strility/-/机器人学院项目报告-徐炜涛-罗文荣.docx

机器人学院项目报告

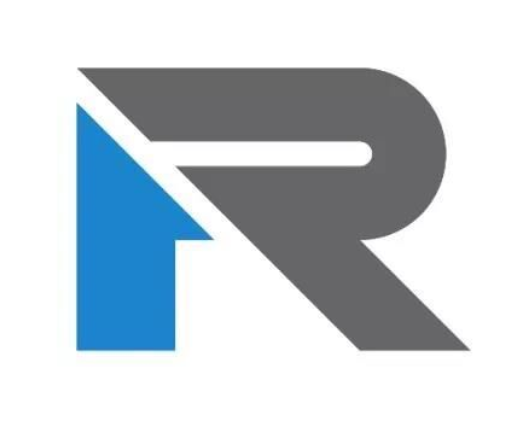
[picture p1: figure]

项 目 题 目： MADE小船

学 院 名 称： 机器人学院

专 业： 网络工程

班 级： 网络182

姓 名： 徐炜涛 学 号 18401190125

姓 名： 罗文荣 学 号 18404130277

指 导 教 师： 汪保

完成日期： 2019 年 11 月 10 日

目录

摘要¨¨¨¨¨¨¨¨¨¨¨¨¨¨¨¨¨¨¨¨¨¨¨¨¨¨¨¨¨¨¨¨¨¨¨¨¨¨¨¨¨¨¨¨¨¨¨¨¨¨¨¨¨¨¨¨¨¨¨¨¨¨¨¨¨¨3

前言¨¨¨¨¨¨¨¨¨¨¨¨¨¨¨¨¨¨¨¨¨¨¨¨¨¨¨¨¨¨¨¨¨¨¨¨¨¨¨¨¨¨¨¨¨¨¨¨¨¨¨¨¨¨¨¨¨¨¨¨¨¨¨¨¨¨4

一、项目背景¨¨¨¨¨¨¨¨¨¨¨¨¨¨¨¨¨¨¨¨¨¨¨¨¨¨¨¨¨¨¨¨¨¨¨¨¨¨¨¨¨¨¨¨¨¨¨¨¨¨¨¨¨¨¨¨5

1.1设计理由（设计背景）¨¨¨¨¨¨¨¨¨¨¨¨¨¨¨¨¨¨¨¨¨¨¨¨¨¨¨¨¨¨¨¨¨¨¨¨¨¨¨¨¨¨5

1.2项目要求介绍¨¨¨¨¨¨¨¨¨¨¨¨¨¨¨¨¨¨¨¨¨¨¨¨¨¨¨¨¨¨¨¨¨¨¨¨¨¨¨¨¨¨¨¨¨¨¨¨¨¨¨¨5

二、小船材料与制造操作过程¨¨¨¨¨¨¨¨¨¨¨¨¨¨¨¨¨¨¨¨¨¨¨¨¨¨¨¨¨¨¨¨¨¨¨¨¨¨¨5

2.1小船材料简介¨¨¨¨¨¨¨¨¨¨¨¨¨¨¨¨¨¨¨¨¨¨¨¨¨¨¨¨¨¨¨¨¨¨¨¨¨¨¨¨¨¨¨¨¨¨¨¨¨¨¨¨5

2.2小船工艺与设计¨¨¨¨¨¨¨¨¨¨¨¨¨¨¨¨¨¨¨¨¨¨¨¨¨¨¨¨¨¨¨¨¨¨¨¨¨¨¨¨¨¨¨¨¨¨¨¨¨¨5

三、小船的推导思路与代码¨¨¨¨¨¨¨¨¨¨¨¨¨¨¨¨¨¨¨¨¨¨¨¨¨¨¨¨¨¨¨¨¨¨¨¨¨¨¨¨¨¨6

3.1推导模型¨¨¨¨¨¨¨¨¨¨¨¨¨¨¨¨¨¨¨¨¨¨¨¨¨¨¨¨¨¨¨¨¨¨¨¨¨¨¨¨¨¨¨¨¨¨¨¨¨¨¨¨¨¨¨¨¨7

3.1.1整体思路¨¨¨¨¨¨¨¨¨¨¨¨¨¨¨¨¨¨¨¨¨¨¨¨¨¨¨¨¨¨¨¨¨¨¨¨¨¨¨¨¨¨¨¨¨¨¨¨¨¨¨¨7

3.1.2重心、浮心¨¨¨¨¨¨¨¨¨¨¨¨¨¨¨¨¨¨¨¨¨¨¨¨¨¨¨¨¨¨¨¨¨¨¨¨¨¨¨¨¨¨¨¨¨¨¨¨¨¨8

3.1.3四个阶段¨¨¨¨¨¨¨¨¨¨¨¨¨¨¨¨¨¨¨¨¨¨¨¨¨¨¨¨¨¨¨¨¨¨¨¨¨¨¨¨¨¨¨¨¨¨¨¨¨¨¨¨8

3.1.3.1第一阶段0-1¨¨¨¨¨¨¨¨¨¨¨¨¨¨¨¨¨¨¨¨¨¨¨¨¨¨¨¨¨¨¨¨¨¨¨¨¨¨¨¨¨¨¨8

3.1.3.2第二阶段1-90¨¨¨¨¨¨¨¨¨¨¨¨¨¨¨¨¨¨¨¨¨¨¨¨¨¨¨¨¨¨¨¨¨¨¨¨¨¨¨¨¨10

3.1.3.3第三阶段90-2¨¨¨¨¨¨¨¨¨¨¨¨¨¨¨¨¨¨¨¨¨¨¨¨¨¨¨¨¨¨¨¨¨¨¨¨¨¨¨¨11

3.1.3.3第四阶段2-180¨¨¨¨¨¨¨¨¨¨¨¨¨¨¨¨¨¨¨¨¨¨¨¨¨¨¨¨¨¨¨¨¨¨¨¨¨¨¨12

3.2代码设计¨¨¨¨¨¨¨¨¨¨¨¨¨¨¨¨¨¨¨¨¨¨¨¨¨¨¨¨¨¨¨¨¨¨¨¨¨¨¨¨¨¨¨¨¨¨¨¨¨¨¨¨¨¨¨¨13

4.1题目模型解答¨¨¨¨¨¨¨¨¨¨¨¨¨¨¨¨¨¨¨¨¨¨¨¨¨¨¨¨¨¨¨¨¨¨¨¨¨¨¨¨¨¨¨¨¨¨¨¨¨¨14

四、结论与感悟¨¨¨¨¨¨¨¨¨¨¨¨¨¨¨¨¨¨¨¨¨¨¨¨¨¨¨¨¨¨¨¨¨¨¨¨¨¨¨¨¨¨¨¨¨¨¨¨¨¨¨¨¨18

参考文献¨¨¨¨¨¨¨¨¨¨¨¨¨¨¨¨¨¨¨¨¨¨¨¨¨¨¨¨¨¨¨¨¨¨¨¨¨¨¨¨¨¨¨¨¨¨¨¨¨¨¨¨¨¨¨¨¨¨¨¨19

MADE小船设计与实现

# 摘要：船舶在海上行驶会遇到海浪导致船舶飘忽不定，因此在设计船舶的时会将船设计地有较好地稳定性，船舶的稳定性是指船舶在有限的作用下不会倾覆，倾侧性消失后能恢复到正常状态的能力。

# 决定船舶稳定性的一大关键元素就是复原力矩， 复原力矩是指船舶受外力作用倾斜时由于重力和浮力的作用点不在同一铅垂线上所产生的使船恢复正态的恢复力矩当重心和浮心不在同一垂线上，重力和浮力形成力偶，促使船回到初始平衡位置，此时的复原力矩为正值。当重力和浮力形成的力偶，促使船继续横倾，此时的复原力矩为负值，当复原力矩达到负值的一瞬间就是最大AVS消失角。

# 对于船舶稳定性我们可以通过设计船的模型(船体方程)和改变船的重心来达到我们需要的最大恢复力矩，使船达到我们的要求。

# 模型设计与代码设计：本文采用了先推导公再结合代码迭代设计船体最后进行制作。

# 文中主要就对小船的相关结构设计与恢复力矩计算做了相关的综述。

关键词：微积分；船舶稳定性；恢复力矩；AVS稳定消失角

前言

为了让我们数学更贴近生活也为了增强我们对微积分认识，学院布置了小船项目，小船项目是通过教师给出一定要求，里面包含物理、数学、编程等一些列的要求，整合多种工具最后完成小船，小船项目要求分为几种测试，静平衡测试：船满载时放入水中，能够漂浮，且甲板平面与标识线（水面）平行。稳定性测试： 主要观测稳性消失角是否达到 135±10°。最大恢复力矩测试：根据 135°倾角时围绕浮心的转动惯量 J（单位用 kg·m2)和测量所得周期 T(单位用 s),计算得到该船的最大恢复力矩值，大于或等于 0.2 N·m 的该项合格，小于 0.2 N·m 的不合格。行进性能测试：单位时间内速度最大。

一、项目背景

1.1设计背景

为了加强我们对物理、微积分和编程与现实的联系，学院开展了小船项目：目的是培养综合运用所学的基础理论，基本知识和技能，提高分析解决实际问题的能力。提高实际工作能力和协作能力：如调查研究、查阅文献和收集资料并进行分析的能力；制定设计或实验方案的能力；设计、计算和绘图能力；总结提高撰写论文的能力。

1.2项目要求介绍

小船项目要求做出的小船满足以下要求：船满载时放入水中，能够漂浮，且甲板平面与标识线（水面）平行。主要观测稳性消失角是达到 135±10°。最大恢复力矩测试：在 135°倾角时围绕浮心的恢复力矩大于等于 0.2 N·m 的该项合格。行进性能测试：给予相同的力在一定距离内行驶时间越短得分越高。

二、小船材料与制造操作过程

2.１小船材料简介

学院提供硬质板、铁质重物、铝质桅杆、塑料薄膜、胶带、胶水、剪刀、美工刀。如图2-1：

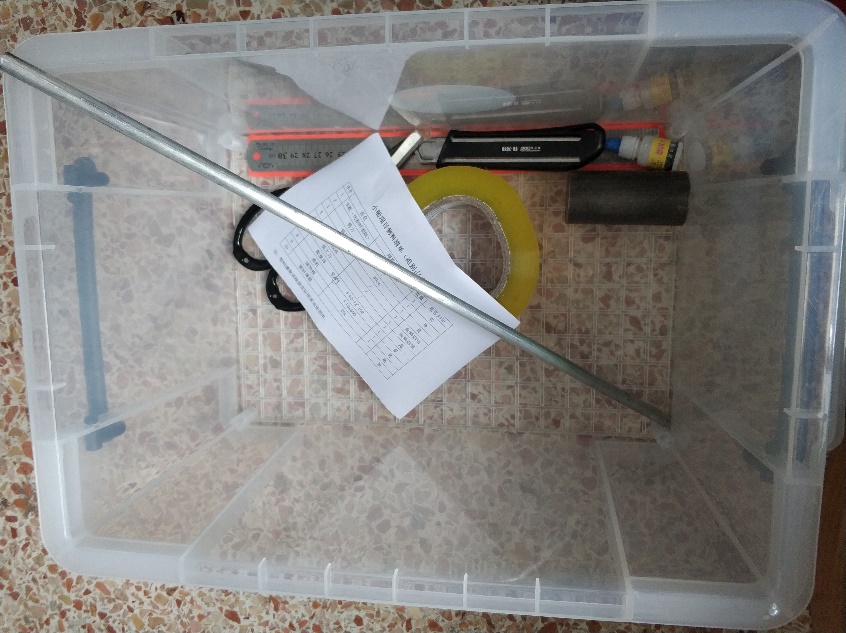
[picture p2: figure]

图 2-1

2.2小船工艺与设计

小船船体设计需要方程，方程设计选择的是二次方程，因为二次方程有着良好的对称性，并且二元二次方程更容易计算，虽然最终计算是交给计算机计算，但是由于二次方程本身简单，我们能人为化简积分，可以较大减少计算机计算时间。然后我们可以对方程进行计算，通过计算以后得出相应数据后就可以设计船体，还可以对船体进行预留装饰位置，然后使用CAD画出平面切割图2-2，也可以使用solidwork建立3D图形模拟，如2-3图：(这里的图形为最终完成的图形设计)

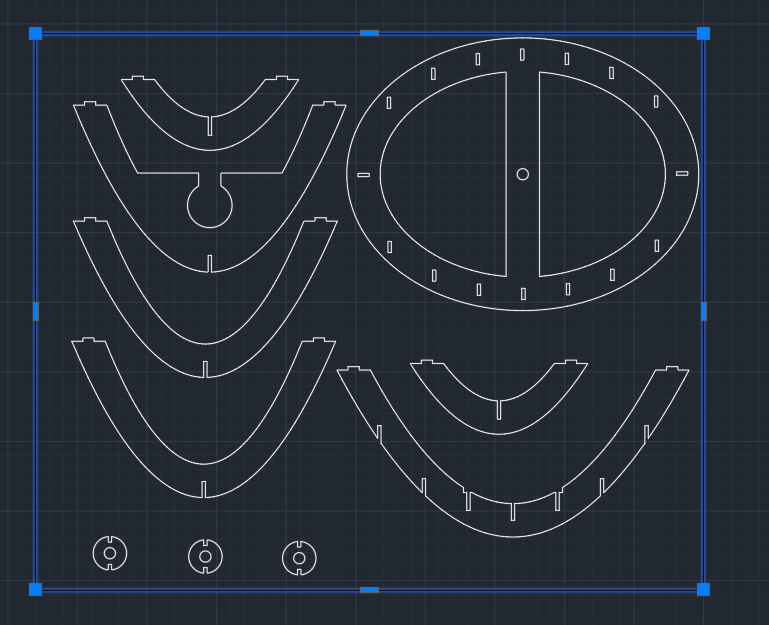
[picture p3: figure]
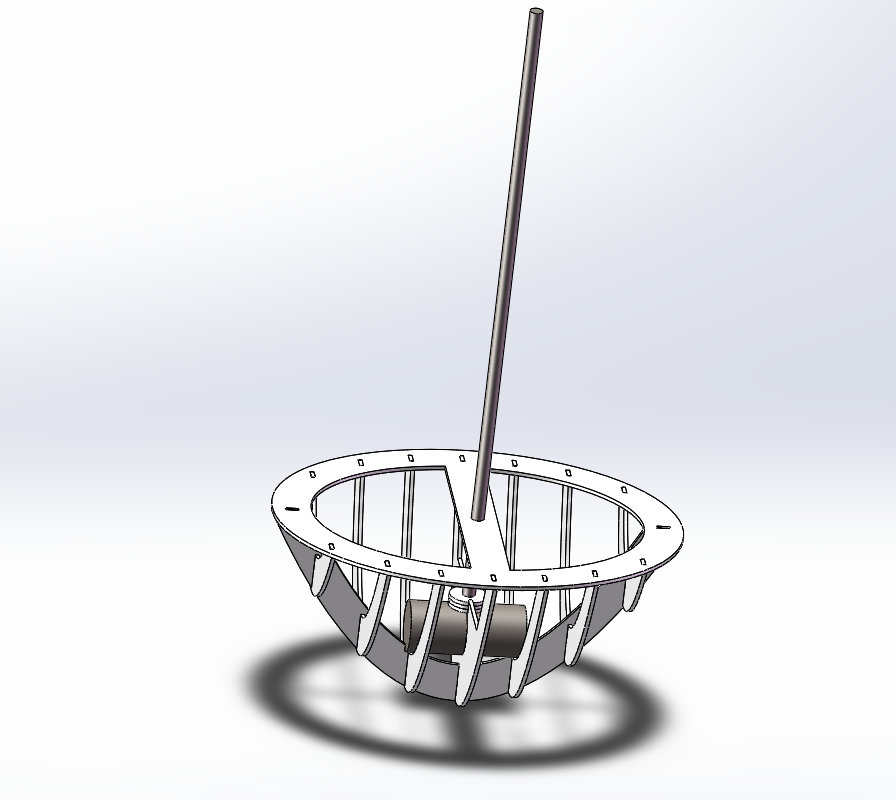
[picture p4: figure]

图2-2 图2-3

然后让老师审核切割图纸，在图纸不存在切割问题后就可以交给老师切割，切割过程不参与。最后组装、做好防水处理与装饰。

三、小船方程推导思路与代码

3.1推导模型

3.1.1整体思路

首先船体是三维立体图形，我们以（0，0，0）为原点这个点也是船的最低点，我们的目标是使得制造出来的船稳定消失角处于135±10°。所以这是最低的限定条件，由于物理知识我们可以知道船只要船在水中浮起，浮力永远等于重力（不进水的情况下）这样我们得到了一个重要的限定方程。①，因此无论后面吃水线如何变化都处于这个限定方程里面。

整体思路的思维导图3-1：

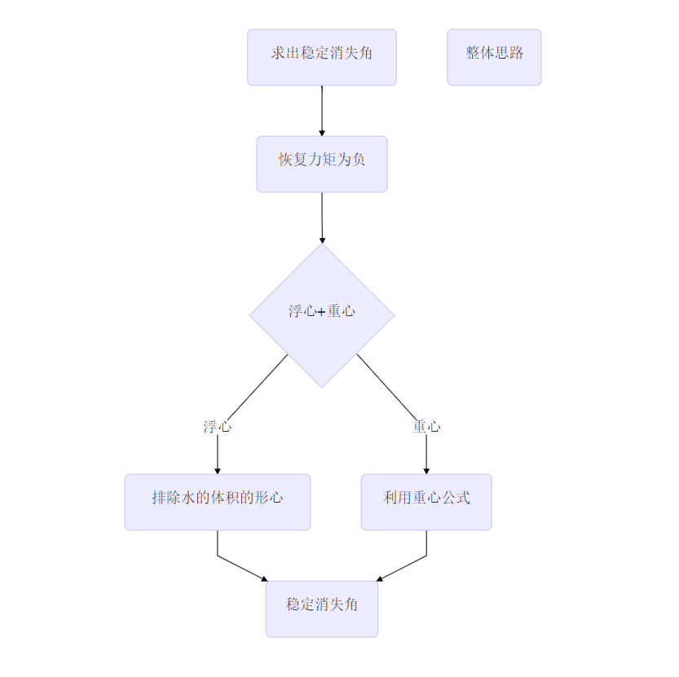
[picture p5: figure]

图 3-1

3.1.2重心、浮心

通过思维导图我们得知为了求出稳定消失角需要求出重心和排水的形心，根据测量我们得知材料的总重，我们可以通过粗略估计所需的船体重量就可以算出总重量，得出总体总量就可以利用①得出排水体积，我们知道我们的方程为我们可以粗略设定A、B和船高H，然后可以利用。

重心方程求解：

②(,,)

就可以得出船体的重心位置。

接下来就是浮心位置：浮心为排开水体积的形心，由于我们选择的是对称性良好的二元二次方程，所以我们在计算吃水线的时候我们可以选择对一个象限进行积分然后推广到其余四个象限。（由于我们是按照Y轴旋转的，所以可以忽略Y轴的积分，所以此处如果选择二重积分也是可以的，但是三重积分更为直观）

浮心求解：

我们需要得到排开水的体积，可以利用我们在前面的到重要限定方程使用①推导出来积分区域为：（，， ）

通过程序二分迭代得到吃水线，得到吃水线以后我们可以使用形心定义求得他在静水中的浮心，分别对x、z轴使用③和④就能得到浮心坐标

3.1.3四个阶段

求得静止时刻的浮心以后我们开始求解从0-180之间的复原力矩，求得复原力矩=复原力臂x力，力为重力，力臂我们可以用浮心和重心求得力臂长度。我们选择以船体为固定中心，让水面旋转，由于绕着Y轴旋转，我们将平立体船和水面看成二维图像，这样更直观，并且这个时候我们的模型可以简化成为一个平面与直线，求解这两个方程的解就能得到他们的交点类似图中的两个交点，我们知道排水体积不变，那么我们设从0°开始往上增加，每增加1°就能得到相对应的截距C这样，就是已知方程了，再联立得到下面图3-1-4

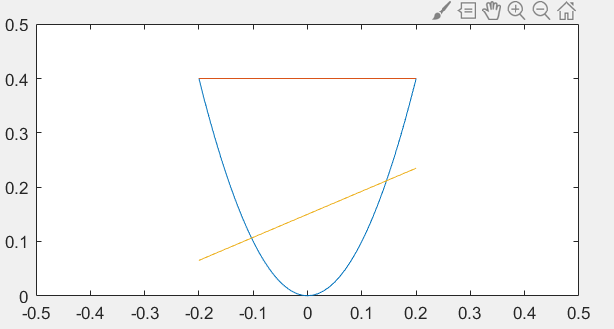
[picture p6: figure]

图3-1-4

而联立方程以后我们可得

方程的解为与，当船体到达吃水线附近的极限值也是约束条件与

这个过程需要分成4个阶段

这4个阶段的思维导图3-1-5：

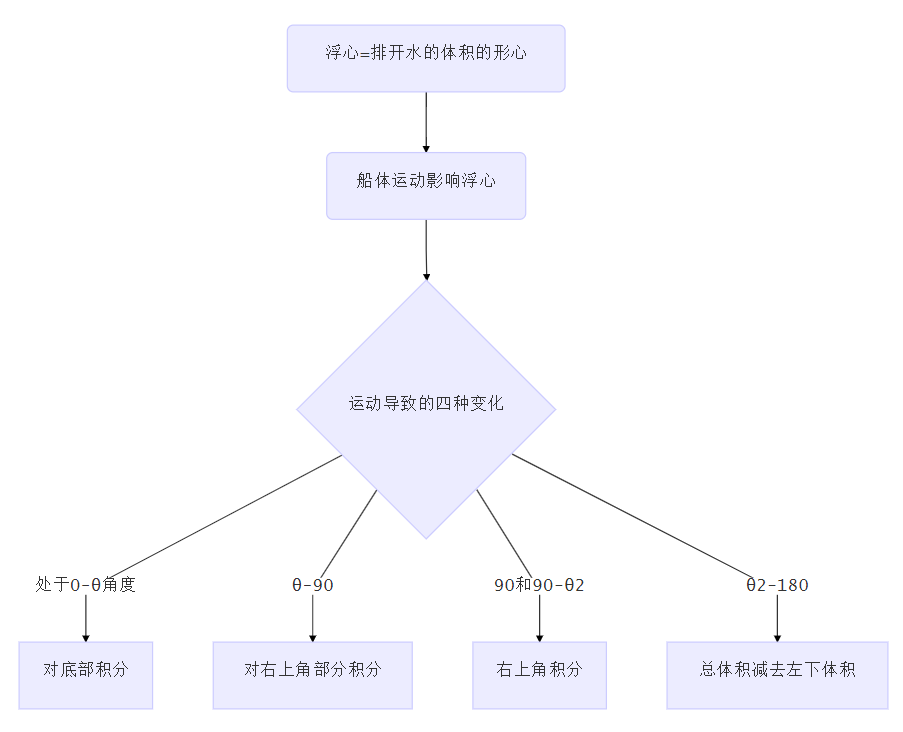
[picture p7: figure]

图 3-1-5

3.1.3.1第一阶段0-1

阶段二维图3-1-3-1-1与三维图3-1-3-2-2

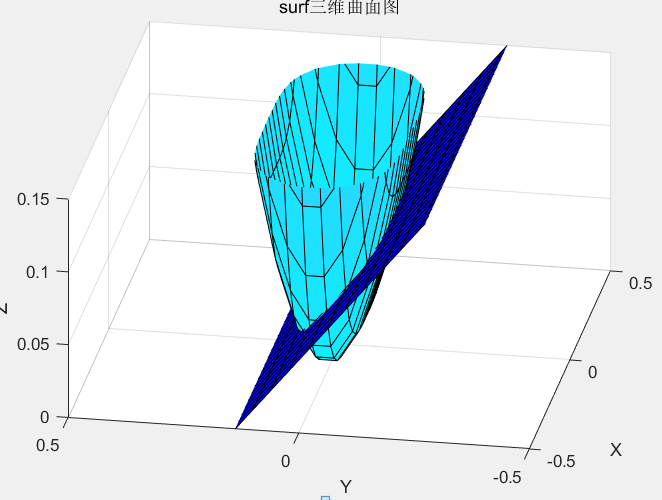
[picture p8: figure]

图3-1-3-1-1 图3-1-3-1-2

当角度小于的时候的积分区域为Z轴的上下限为积分区域为：

（、）

（x的积分区域为）

然后再按照上面求浮心的方法，求得此时的浮心即可。

3.1.3.2第二阶段1-90

阶段二维图3-1-3-2-1 与三维图3-1-3-2-2

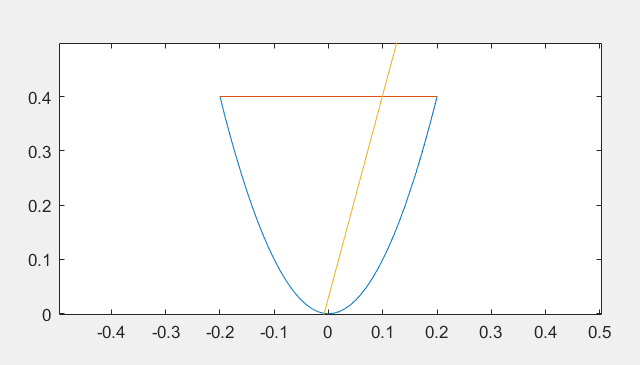
[picture p9: figure]
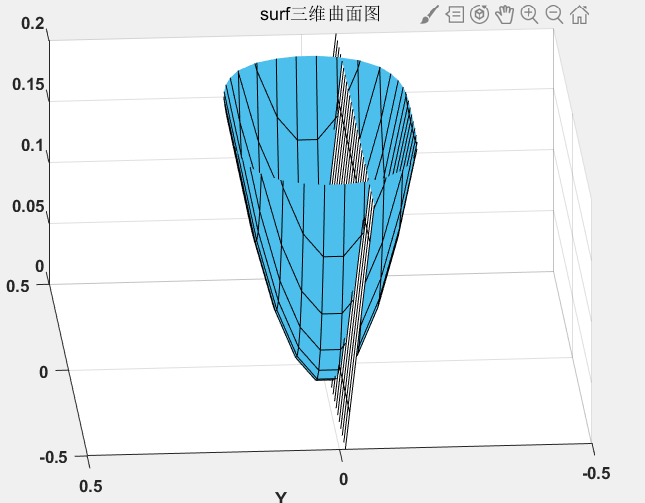
[picture p10: figure]

图3-1-3-2-1 图3-1-3-2-2

当x大于小于90的时候积分区域为两部分：

第一部分： （x的积分区域为）

第二部分： （x的积分区域为

两部分积分加得到此时总积分再利用上面求浮心方法求得此时浮心

3.1.3.3第二阶段90-2

此时可以特判一次90°的吃水线，也可以跳过因为影响不大。

阶段二维图3-1-3-3-1与三维图3-1-3-3-2

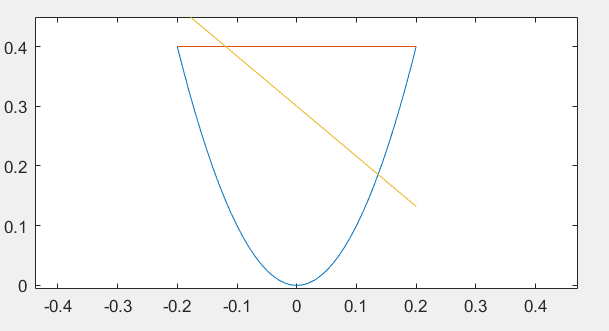
[picture p11: figure]
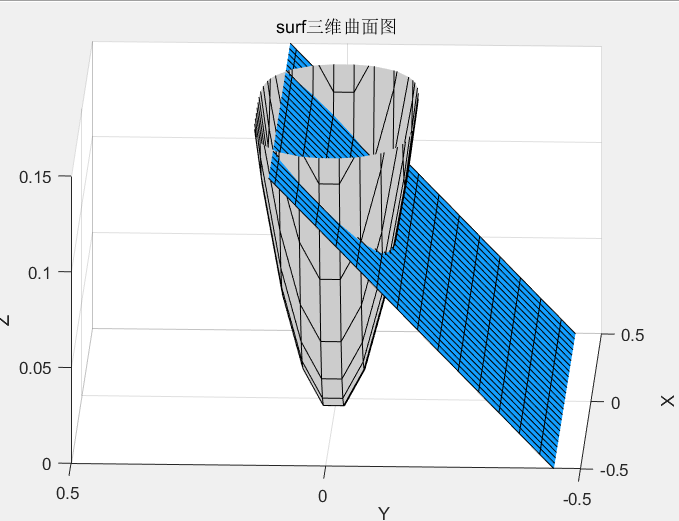
[picture p12: figure]

图3-1-3-3-1 图3-1-3-3-2

当x大于90小于2的时候积分区域为两部分：

第一部分： （x的积分区域为）

第二部分： （x的积分区域为

两部分体积相加再利用上面求浮心方法求得浮心即可。

3.1.3.4第二阶段2-180

这个阶段有两种方法求得体积，一种是求得上面部分的三部分积分，另外一种就是求得总体积然后减去下半部分的积分体积也能达到，我选择的是减法，会少一个积分。

阶段二维图3-1-3-4-1与三维图3-1-3-4-2

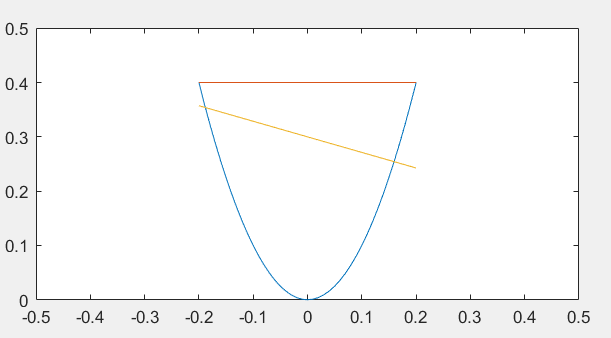
[picture p13: figure]
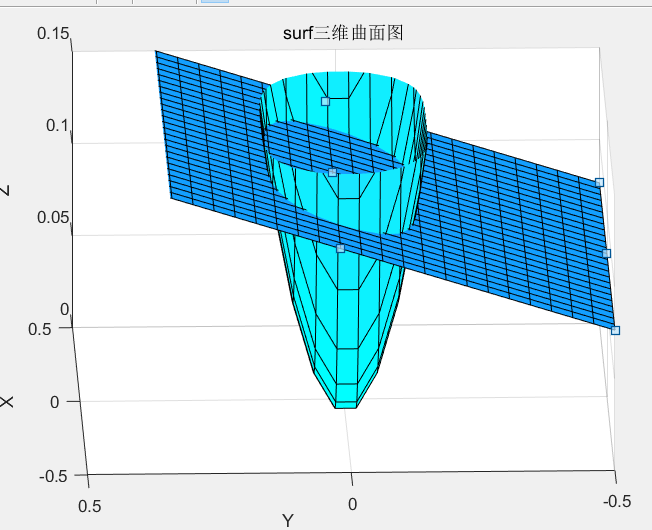
[picture p14: figure]

图3-1-3-4-1 图3-1-3-4-2

当x大于2小于180的时候积分区域为两部分：

总体部分：（x的积分区域为）

减去下部分（x的区域为）

然后按照上面的方法求浮心。

重心不变，并且我们有了个个阶段的浮心，直接利用两直线之间的距离就能求得力臂长度，复原力矩=力臂长度x重力

这样，每个阶段的复原力矩都能算出来。

3.2代码设计

3.2.1总体设计思路

代码的设计思路其实是与推导思路紧紧联系的，因为方程推出来之后代码只能进行计算，起到一个简化运算的效果，所以代码的思维导图为一个主函数控制基础数据然后下面的分支以下为思维导图图3-2-1

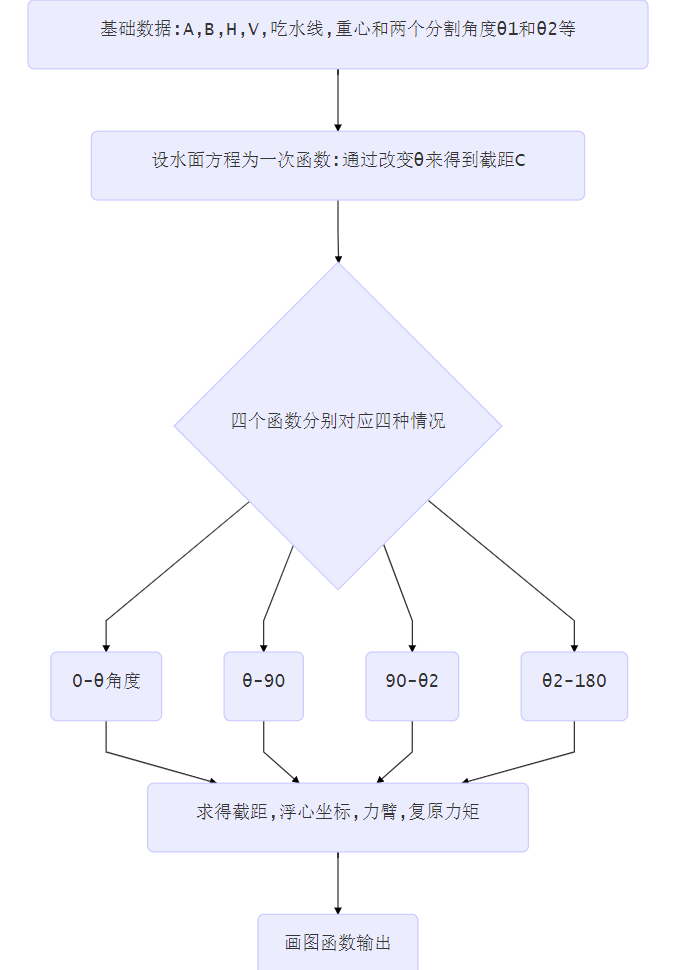
[picture p15: figure]

图3-2-1

4.1题目模型解答

前提：完成代码和推导过程以后就可以确定方程确定的船体方程与水面方程为其中实际小船=0.15m,A、B系数分别为10和6，根据方程可以得出实际长宽分别为0.31.6m、0.245m。

而水面方程可通过改变的角度来得到截距C然后求解。

1：求出小船底部曲面方程及船高

小船方程：

2：求出龙骨方程、截面方程及甲板方程

龙骨方程：

截面方程：

甲板方程·：

3：求出重心及小船向 x 轴倾斜 135°（船体封闭）时的浮心及复原力矩以下的坐标均为笛卡尔坐标系，分为原点坐标为（0，0，0）船头方向为Y轴，船侧方向为X,桅杆正方向为Z轴。小船在倾斜的时候是沿着y轴倾斜的，所以我们可以直接使用y=0，并且由于我们的船是高度对称的小船，并且我们的A、B已经确定，它处于范围在90°-2°，此时模型为上面模型的第三种：

这时候的积分分为两段左边的两段分别为x的上下限：

和 {, &H_吃 =Ax^2 +By^2 , &H_吃 =tanθx+c 使用上面的模型积分得出此时得到

浮心位置为（0.059398，0，0.133374）

重心位置：

重物位置=6cm（船底的距离）+2cm（重物宽度）

桅杆位置=重物z轴位置+桅杆长度/2

对船的薄板积分，算出重心z轴带入重心公式

重心公式;

(,,)

得到：（0，0，0.085）

力臂长度：利用两直线之间的距离公式

方向由角度决定。

力臂长度：0.001123m

计算得到恢复力矩：-0.012549N/m

4:求吃水线

已知的估算排水体积：1.14kg

船的方程，进行三重积分和二分迭代得到水平截距的吃水线：0.074975m

5：画数量关系图

5.1：画出重物质量与吃水线关系的曲线图4-5-1

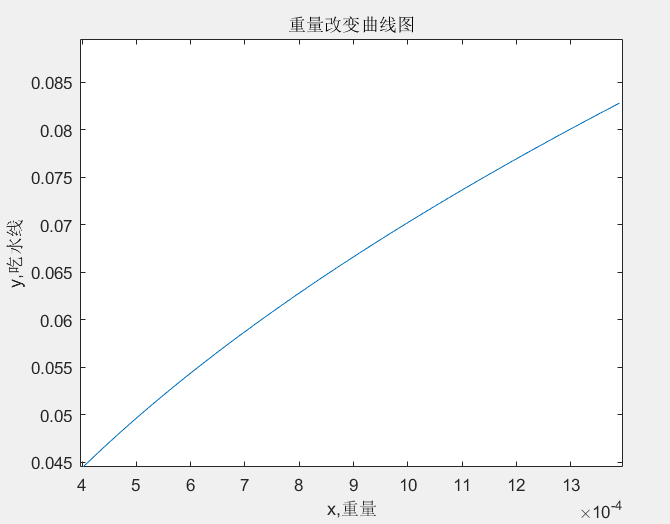
[picture p16: figure]

图4-5-1

5.2：画出船长、宽、高分别与复原力矩关系的曲线图

船体在0-180°的复原力矩图4-5-2：

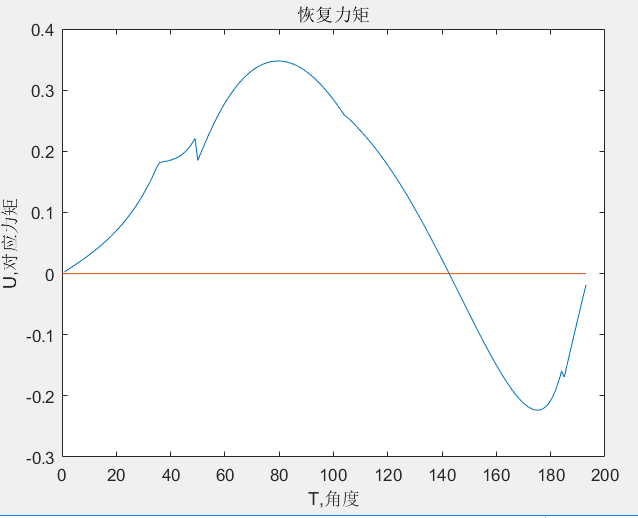
[picture p17: figure]

图4-5-2

5.3：画出重物质量与重心关系的曲线图4-5-3（曲线图的纵横坐标表示重心坐标，曲线上的点的）

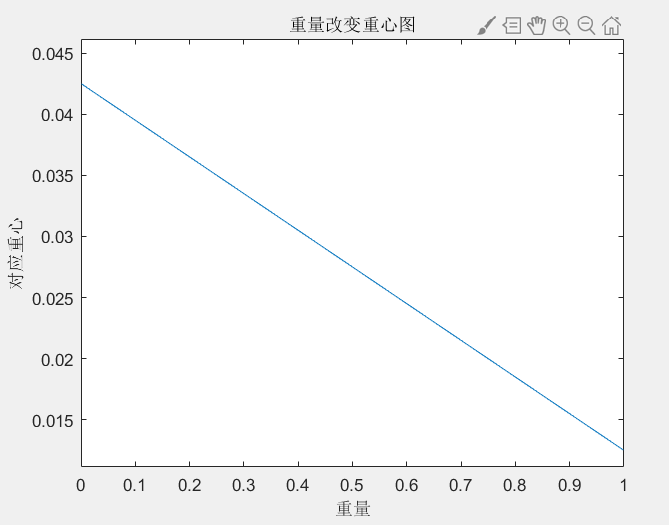
[picture p18: figure]

图4-5-3

四、结论与感悟

通过计算我们的小船在测试中达到了比较良好的效果，精准是吃水线、125°的AVS消失角度、较好的复原力矩、不错的速度，这次项目中由于选择了简单的二元二次函数，所以在计算的时候一开始使用了手算（matlab在三重积分中变现不佳造成的，速度巨慢，跑一个180的AVS角度需要20分钟）然后手动积分成一重积分以后速度提升了好多好多（这已经不能用快来说了，这是非常快），当然简单的二元二次函数不仅在我们化简中提供了很多方便，在求根的时候也是可以使用求根公式，而不用选择迭代求解（迭代求解虽然误差不大，但终归是误差），好的程序能让题目更快解决，但是一开始的方向很重要，在一开始的时候我们选择了以直代曲，然后在AVS哪里求不出浮心，因此耽搁了很久，最后发现曲面才是最简单的，因为软件可以算，所以，最重要的是数学思维，方向对了，那就离成功不远了。

[^1]

[^1] 参考文献 [1] James Stewart. Calculus, 2014. 附件：代码 主函数： %/*-----小船项目-------*/ %/*-作者：徐炜涛-------*/ %/*-功能：找寻复原力矩-*/ %/*-时间：2019-11-6--*/ %/--------------------*/ %/*-------首先确定方程为二次方程H=A*x^2+B*y^2---------*/ format long; syms x y; V_all=0.002;%此处为船的体积m3--是指当船满排水的时候的排水体积 %/*-----最简方程 A B 为用来反推的数据，H为船高 h为吃水线----*/ F_boat=@(x,y,H)A*x^2+B*y^2-H; A=10;%系数 B=6; H=0.15; m_L=0.084; %重物长度为后面cad画图需要的参数 %由于良好的对称性，所以只需要考虑gz的位置 m_iron=0.8234;%重物质量 m_mast=0.1;%桅杆质量 m_focus_z=0.01+0.02;%龙骨高度+重物宽 重物z轴重心 m_boat_z=0.05;%船的重心 m_mast_z=0.04+0.01+0.25;%桅杆重心位置 %重心 center=calculate_center(m_focus_z,m_boat_z,m_mast_z); m_total_z=(m_focus_z*0.8234+m_boat_z*0.25+m_mast_z*0.1);%此处的船体重心 %Art=get_add_tie_art(A,B,H);%画出重量增加的图 V_boat=0.0012;%此处为船的排除体积m3--实际排水体积（船的大致重量都可以测出） %求浮心公式 %求出的浮心会在下面进行输出 %while(A<20) %调用the_main函数： %/*--每个the_main函数都代表个每个阶段求得的复原力矩--*/ %/*--其中分为几个阶段：--------------*/ %/*--第一阶段：0-左上方交点----------*/ %/*--第二阶段：左上方交点-90---------*/ %/*--第三阶段：90-右上方交点---------*/ %/*--第四阶段：接近180的吃水---------*/ %/*-- %/*--每个 X=the_main2(A,B,H,V_boat,m_total_z); Y=the_main3(A,B,H,V_boat,m_total_z); %Z=the_main4(A,B,H,V_boat,m_total_z); F=the_main5(A,B,H,V_boat,m_total_z); T=the_main6(A,B,H,V_boat,m_total_z); %fprintf("%d\n",K); %把结果储存到矩阵中然后再制图 % X=[X Y F]; %end f_water_line=the_0_to_xita(A,B,H,V_boat);%吃水线 fun_float=@(x) (f_water_line^2-A^2*x^4-(f_water_line^2-2*A*x^2*f_water_line+A^2*x^4)/5)*(f_water_line-A*x^2); float_z=quadv(fun_float,0,(f_water_line/A)^0.5)/0.0012; flaot_z=float_z*2/sqrt(B); %画图函数 % F=water_line_art(A,B,H,f_water_line); %输出 % fprintf("吃水线为%d\n",f_water_line); % fprintf("船体重心位置(0,0,%d)\n",m_total_z); % fprintf("船体浮心位置为(0,0,%d)\n",float_z); % fprintf("%f",F_obtain); 力臂函数： %/*----求力臂长度----*/ %/*----方向由角度定--*/ function L=get_the_L(float_avs_Z,float_avs_X,m_mast_z,z) L=(float_avs_Z-m_mast_z)*sin(z)+float_avs_X*cos(z); End 主函数0-西塔角度 %0-西塔角度的力矩和浮心 %求取函数第一步找到西塔角再以角度为分界线无限逼近 %每提升一个角度就会计算出一个截距值 function F=the_main2(A,B,H,V_boat,m_total_z) X=[]; theat=obtain_theat(H,A,B,V_boat);%1:找到角度 i=1; while(i<100) z=i/180*pi; if(z>theat) break; end %fprintf("这是第%f个i",i); %/*------得到截距C----*/ %/*------吊塔---------*/ %/*------积分上下限---*/ %/*------求取浮心坐标--*/ %/*------力臂长度-----*/ %/*------力矩大小-----*/ C=get_intercept(A,B,H,V_boat,z); b=(tan(z)^2+4*A*C)^0.5; x_min=(tan(z)-b)/(2*A); x_max=(tan(z)+b)/(2*A); float_avs_Z=float_Z(A,B,H,V_boat,z,x_min,x_max); float_avs_X=float_X(A,B,H,V_boat,z,x_min,x_max); Restoring_L=get_the_L(float_avs_Z,float_avs_X,m_total_z,z); Restoring_data=Restoring_L*11.7600000000000; X=[X Restoring_data]; i=i+1; fprintf("这是第%d:力臂%f 力矩%f\n",i-1,Restoring_L,Restoring_data); end F=X; End 西塔到90： %西塔-90的力矩和浮心 %/*----此处的积分为两部分----*/ %/*----积分区域为右下和右上--*/ %/*----注意积分上下限-------*/ %/*----其余原理和上一个函数一样-*/ function F=the_main3(A,B,H,V_boat,m_mast_z) X=[]; theat=obtain_theat(H,A,B,V_boat); i=theat*180/pi+1; while(i<90) %fprintf("这是第%f个i",i); %/*------得到截距C----*/ %/*------吊塔---------*/ %/*------积分上下限---*/ %/*------求取浮心坐标--*/ %/*------力臂长度-----*/ %/*------力矩大小-----*/ z=i/180*pi; C=get_intercept(A,B,H,V_boat,z); float_avs_Z=float_Z_45(A,B,H,V_boat,z); float_avs_X=float_X_45(A,B,H,V_boat,z); %fprintf("浮心坐标为（%f，0,%f)\n",float_avs_X,float_avs_Z); Restoring_L=get_the_L(float_avs_Z,float_avs_X,m_mast_z,z); Restoring_data=Restoring_L*11.7600000000000; X=[X Restoring_data]; fprintf("这是第%d :力臂%f 力矩%f\n",i,Restoring_L,Restoring_data); i=i+1; end F=X; end 90-西塔2： %/*----此处的积分为两部分----*/ %/*----积分区域为右下和右上--*/ %/*----注意积分上下限-------*/ %/*----其余原理和上一个函数一样-*/ function F=the_main4(A,B,H,V_boat,m_total_z) X=[]; theat=obtain_theat(H,A,B,V_boat); j=theat*180/pi+1; i=91; while(i<145) z=i/180*pi; %fprintf("这是第%f个i\n",i); c=get_intercept_90_180(A,B,H,V_boat,z); %fprintf("%f\n",c); float_avs_Z=float_Z_90_180(A,B,H,V_boat,z); float_avs_X=float_X_90_180(A,B,H,V_boat,z); %fprintf("浮心坐标为（%f，0,%f)\n",float_avs_X,float_avs_Z) ; Restoring_L=get_the_L(float_avs_Z,float_avs_X,m_total_z,z); Restoring_data=Restoring_L*11.7600000000000; X=[X Restoring_data]; fprintf("这是第%d :力臂%f 力矩%f\n",i,Restoring_L,Restoring_data); i=i+1; end F=X; End 西塔2-180 %/*----此处的积分为两部分----*/ %/*----积分区域为总-右下--*/ %/*----注意积分上下限-------*/ %/*----其余原理和上一个函数一样-*/ function F=the_main6(A,B,H,V_boat,m_total_z) X=[]; theat=max_theat__(H,A,B,V_boat); j=theat*180/pi; i=j; while(i<180) z=i/180*pi; %fprintf("这是第%f个i\n",i); c=get_intercept_last(A,B,H,V_boat,z); %fprintf("%f\n",c); float_avs_Z=float_Z_last(A,B,H,z,c); float_avs_X=float_X_last(A,B,H,z,c); %fprintf("浮心坐标为（%f，0,%f)\n",float_avs_X,float_avs_Z) ; Restoring_L=get_the_L(float_avs_Z,float_avs_X,m_total_z,z); Restoring_data=Restoring_L*11.7600000000000; X=[X Restoring_data]; % fprintf("这是第%d :力臂%f 力矩%f\n",i,Restoring_L,Restoring_data); i=i+1; end F=X; % W=0:0.1:0.35; % S=10*W.^2; % plot(W,S); % hold on; % syms x; % R=tan(130/180*pi)*x+c; % plot(W,R); %fprintf("%f\n",j); end 获取每一次得到的截距C function the_theta=obtain_theat(H,A,B,V_boat) i=1; while(i<90) theta=i/180*pi; %fprintf("这是第%f角度\n",i); c=H-tan(theta)*(H/A)^0.5; F=@(x)(tan(theta)*x+c-H/3-2*A*x^2/3)*sqrt(H-A*x^2); %2*(H-A*x.^2)^1.5/3+tan(theta)*(x-sqrt(H/A)).*sqrt(H-A*x.^2); x_min=(tan(theta)-(tan(theta)^2-4*A*c)^0.5)/(2*A); x_max=(H/A)^0.5; V_temp=quadv(F,x_min,x_max); if(V_temp<V_boat) break; end i=i+1; end the_theta=i/180*pi; end 得到西塔角2 %/*----得到最大的倾斜角度----*/ %/*----总积分-下积分得到----*/ function F=max_theat__(A,B,H,V_boat) i=91; cof=4/(3*sqrt(B));%常系数 while(i<180) theta=i/180*pi; %fprintf("%dth calculate:",i);% c=H+tan(theta)*sqrt(H/A); d=tan(theta)^2+4*A*c; %fprintf("d is %f,",d);% fun=@(x) (H-tan(theta)*x+c)*(tan(theta)*x+c-A*x^2)^0.5; xmin=-sqrt(H/A); xmax=(tan(theta)+sqrt(d))/(2*A); volumn=quadv(fun,xmin,xmax); volumn=volumn*cof; Fun=@(x) (H-A*x.^2).^1.5; Cof=8/(3*sqrt(B));% V=quadv(Fun,xmax,-xmin); V=V*Cof; %fprintf("V is %f,v水上 is %f,",V,volumn);%测试输出 volumn=V-volumn; %fprintf("volumn is %f\n",volumn);%测试输出 if(volumn<V_boat) break; end i=i+1; end F=theta; end 第一阶段得到函数： %/*-----固定积分上下限-------*/ %/*-----得到了角度以后的计算-*/ %/*-----迭代求C-------------*/ function F=get_intercept(A,B,H,V_boat,z) syms x y; c_min=0; c_max=H-tan(z)*(H/A)^0.5; c_center=(c_min+c_max)/2; j=1; while(j<100) fun=@(x)(tan(z)*x+c_center-H/3-2*A*x^2/3)*(H-A*x^2)^0.5; c_x1=(tan(z)-(tan(z)^2-4*A*(tan(z)*(H/A)^0.5-H))^0.5)/(2*A); c_x2=(tan(z)+(tan(z)^2-4*A*(tan(z)*(H/A)^0.5-H))^0.5)/(2*A); V_temp=quadv(fun,c_x1,c_x2); V_temp=V_temp*2/B^0.5; if(V_temp>V_boat) if(c_center<c_max) c_max=c_center; end end if(V_temp<V_boat) if(c_center>c_min) c_min=c_center; end end c_center=(c_min+c_max)/2; j=j+1; end F=c_center; End 第一阶段X浮心： %/*-----确定积分上下限此处为右下积分----*/ %/*-----x的浮心位置坐标直接用积分体积比例表示--*/ %/*-----求出体积质量后直接比总重量----*/ function obtain_avs_X=float_X(A,B,H,V_boat,z,x_min,x_max) C=get_intercept(A,B,H,V_boat,z); %fprintf("这里的C是%f",C) fun=@(x) x*((tan(z)*x+C-H/3-2*A*x^2/3)*sqrt(H-A*x^2)); V_temp=quadv(fun,x_min,x_max); V_temp=V_temp*2/B^0.5; obtain_avs_X=V_temp/V_boat; %fprintf("体积%f\n",V_temp); End 第一阶段Z浮心： %/*-----确定积分上下限此处为右下积分----*/ %/*-----z的浮心位置坐标直接用积分体积比例表示--*/ %/*-----求出体积质量后直接比总重量----*/ function obtain_avs_Z=float_Z(A,B,H,V_boat,z,x_min,x_max) C=get_intercept(A,B,H,V_boat,z); fun=@(x) ((tan(z)*x+C)^2-A^2*x^4-2*A*x^2/3*(H-A*x^2)-(H-A*x^2)^2/5)*(H-A*x^2)^0.5; %(H^2-A^2*x^4)*sqrt(H-A*x^2)-2*A*x^2.*(H-A*x^2)^1.5/3-(H-A*x^2)^2.5/5; V_temp=quadv(fun,x_min,x_max); V_temp=V_temp*2/B^0.5; obtain_avs_Z=V_temp/0.0012; %fprintf("Z的坐标%f\n",obtain_avs_Z); end 第二阶段： function F=get_intercept_45(A,B,H,V_boat,z) c_min=H-tan(z)*(H/A)^0.5; c_max=100;%或0.15； c_center=(c_min+c_max)/2; i=1; while(i<100) d=(tan(z)^2+4*A*c_center)^0.5; x_min=(tan(z)-d)/(2*A); x_max=(H-c_center)/tan(z); x_r=(H/A)^0.5; %左部分 fun1=@(x) 2/3*(tan(z)*x+c_center-A*x^2)^1.5; Vo_1=quadv(fun1,x_min,x_max); Vo_1=Vo_1*2/(B^0.5); %右部分 fun2=@(x) 2/3*(H-A*x^2)^1.5; Vo_2=quadv(fun2,x_max,x_r); Vo_2=Vo_2*(2/(B^0.5)); Vo_all=Vo_1+Vo_2; if(Vo_all>V_boat) if(c_center<c_max) c_max=c_center; end end if(Vo_all<V_boat) if(c_center>c_min) c_min=c_center; end end c_center=(c_min+c_max)/2; i=i+1; end F=c_center; End 第二阶段浮心X： %/*-----确定积分上下限此处为右下积分----*/ %/*-----x的浮心位置坐标直接用积分体积比例表示--*/ %/*-----求出体积质量后直接比总重量----*/ function F=float_X_45(A,B,H,V_boat,z) c=get_intercept_45(A,B,H,V_boat,z); d=(tan(z)^2+4*A*c)^0.5; x_min=(tan(z)-d)/(2*A); x_max=(H-c)/tan(z); x_right=(H/A)^0.5; %左部分 fun1=@(x) 2/3*(tan(z)*x+c-A*x^2)^1.5; Vo_1=quadv(fun1,x_min,x_max); Vo_1=Vo_1*2/(B^0.5); %右部分 fun2=@(x) 2/3*(H-A*x^2)^1.5; Vo_2=quadv(fun2,x_max,x_right); Vo_2=Vo_2*(2/(B^0.5)); Vo_all=Vo_1+Vo_2; %左部分 fun3=@(x) x*2/3*(tan(z)*x+c-A*x^2)^1.5; Vo_3=quadv(fun3,x_min,x_max); Vo_3=Vo_3*2/(B^0.5); %右部分 fun4=@(x) x*2/3*(H-A*x^2)^1.5; Vo_4=quadv(fun4,x_max,x_right); Vo_4=Vo_4*(2/(B^0.5)); Vo_all2=Vo_3+Vo_4; % fprintf("带X的%f %f\n",Vo_all2,Vo_all); F=Vo_all2/Vo_all; % %x轴积分体积区域 % fun1=@(x) x*((tan(z)*x+c-A*x^2)*sqrt(tan(z)+c-A*x^2)-(tan(z)+c-A*x^2)^1.5/3); % Vo_1_x=quadv(fun1,x_min,x_max); % Vo_1_x=Vo_1_x*2/(B^0.5); % fun2=@(x) x*(H-A*x^2)^1.5; % Vo_2_x=quadv(fun2,x_max,x_right); % Vo_2_x=Vo_2_x*(4/(3*B^0.5)); % Vo_all_x=Vo_1_x+Vo_2_x; % % %整体区域 % fun_a1=@(x) ((tan(z)*x+c-A*x^2)*sqrt(tan(z)+c-A*x^2)-(tan(z)+c-A*x^2)^1.5/3); % Vo_x=quadv(fun_a1,x_min,x_max); % Vo_x=Vo_x*2/(B^0.5); % fun_a2=@(x) (H-A*x^2)^1.5; % Vo_a2=quadv(fun_a2,x_max,x_right); % Vo_a2=Vo_a2*(4/(3*B^0.5)); % Vo_all=Vo_x+Vo_a2; % F=Vo_all_x/Vo_all; % fprintf("x的重心位置%f %f\n",Vo_all_x,Vo_all); End 第二阶段浮心Z: %/*-----确定积分上下限此处为右下右上积分----*/ %/*-----x的浮心位置坐标直接用积分体积比例表示--*/ %/*-----求出体积质量后直接比总重量----*/ function F=float_Z_45(A,B,H,V_boat,z) c=get_intercept_45(A,B,H,V_boat,z); d=(tan(z)^2+4*A*c)^0.5; x_min=(tan(z)-d)/(2*A); x_max=(H-c)/tan(z); x_right=(H/A)^0.5; %左部分 fun1=@(x) 2/3*(tan(z)*x+c-A*x^2)^1.5; Vo_1=quadv(fun1,x_min,x_max); Vo_1=Vo_1*2/(B^0.5); %右部分 fun2=@(x) 2/3*(H-A*x^2)^1.5; Vo_2=quadv(fun2,x_max,x_right); Vo_2=Vo_2*(2/(B^0.5)); Vo_all=Vo_1+Vo_2; %左边带Z fun3=@(x) ((tan(z)*x+c)^2-(A*x^2)^2-2*A*x^2*((tan(z)*x+c)-A*x^2)-((tan(z)*x+c)-A*x^2)^2/5)*((tan(z)*x+c)-A*x^2)^0.5; Vo_3=quadv(fun3,x_min,x_max); Vo_3=Vo_3*2/B^0.5; %右边带Z fun4=@(x) (H^2-(A*x^2)^2-2*A*x^2*(H-A*x^2)-(H-A*x^2)^2/5)*(H-A*x^2)^0.5; Vo_4=quadv(fun4,x_max,x_right); Vo_4=Vo_4*2/B^0.5; Vo_all2=Vo_3+Vo_4; %fprintf("带Z的%f %f\n",Vo_all2,Vo_all); F=Vo_all2/Vo_all; % fprintf("V体积总：%f 分：%f\n",Vo_all2,Vo_all); % fun1=@(x) ((tan(z)*x+c)^2-A^2*x^4)*sqrt(tan(z)*x+c-A*x^2)-2*A*x^2*(tan(z)*x+c-A*x^2)^1.5/3-(tan(z)*x+c-A*x^2)^2.5/5; % Vo_z1=quadv(fun1,x_min,x_max); % Vo_z1=Vo_z1*1/B^0.5; % fun2=@(x) (H^2-A^2*x^4)*sqrt(H-A*x^2)-2*A*x^2.*(H-A*x^2)^1.5/3-(H-A*x^2)^2.5/5; % Vo_z2=quadv(fun2,x_max,x_right); % Vo_z2=Vo_z2*(2/(3*B^0.5)); % Vo_z_all=Vo_z1+Vo_z2; % %x的上下限 % fun3=@(x) ((tan(z)*x+c-A*x^2)*sqrt(tan(z)*x+c-A*x^2)-(tan(z)*x+c-A*x^2)^1.5/3); % Vo_a=quadv(fun3,x_min,x_max); % Vo_a=Vo_a*2/(B^0.5); % % fun4=@(x) 2/3*(H-A*x^2)^1.5; % Vo_a2=quadv(fun4,x_max,x_right); % Vo_a2=Vo_a2*(4/(3*B^0.5)); % Vo_all=Vo_a+Vo_a2; % F=Vo_z_all/Vo_all; End 第三阶段： function F=get_intercept_90_180(A,B,H,vp,z) cof=4/(3*sqrt(B)); i=1; cmin=H+tan(z)*sqrt(H/A);%左上交点 cmax=H-tan(z)*sqrt(H/A);%右上交点 c=double((cmin+cmax)/2); while(i<100) d=tan(z)^2+4*A*c; xmin=-sqrt(H/A); xL=(H-c)/tan(z); xR=(tan(z)+sqrt(d))/(2*A); xmax=sqrt(H/A); fun1=@(x) (tan(z)*x+c-A*x.^2).^1.5; v1=quadv(fun1,xL,xR); v1=v1*cof;%水上右 fun2=@(x) (H-A*x.^2).^1.5; v2=quadv(fun2,xmin,xL); v2=v2*cof;%水上左 v=quadv(fun2,xmin,xmax); v=v*cof;%总体积 volumn=v-v1-v2; if(volumn<vp)% if(c<cmax) cmax=c; end end if(volumn>vp)% if(c>cmin) cmin=c; end end if(volumn==vp) break; end c=double((cmin+cmax)/2); i=i+1; end F=c; end 第三阶段浮心Z： %/*-----确定积分上下限此处为右下积分和右上----*/ %/*-----x的浮心位置坐标直接用积分体积比例表示--*/ %/*-----求出体积质量后直接比总重量----*/ function F=float_Z_90_180(A,B,H,V_boat,z) c=get_intercept_90_180(A,B,H,V_boat,z); d=(tan(z)^2+4*A*c)^0.5; x_min=(H-c)/tan(z); x_max=(tan(z)+d)/(2*A); x_r=(H/A)^0.5; x_l=-(H/A)^0.5; fun1=@(x) (H-tan(z)+c)*(tan(z)+c-A*x^2)^0.5; Vo_1=quadv(fun1,x_min,x_max); Vo_1=Vo_1*4/(3*B^0.5); fun2=@(x) (H-A*x^2-(H-A*x^2)/3)*(H-A*x^2)^0.5; Vo_2=quadv(fun2,x_l,x_min); Vo_2=Vo_2*2/B^0.5; Vo_all=Vo_1+Vo_2; Vo_total=quadv(fun2,x_l,x_r); Vo_total=Vo_total*2/(1*B^0.5); Vo_all=Vo_total-Vo_all; fun3=@(x) (H^2-A^2*x^4-2*A*x^2*(H-A*x^2)/3-(H-A*x^2)^2/5)*(H-A*x^2)^0.5; Vo_3=quadv(fun3,x_min,x_max); Vo_3=Vo_3/B^0.5; fun4=@(x) (H^2-A^2*x^4)*sqrt(H-A*x^2)-2*A*x^2*(H-A*x^2)^1.5/3-(H-A*x^2)^2.5/5; Vo_4=quadv(fun4,x_l,x_min); Vo_4=Vo_4*2/(1*B^0.5); Vo_Z=quadv(fun4,x_l,x_r); Vo_Z=Vo_Z*(2/(1*B^0.5)); Vo_all2=Vo_3+Vo_4; Vo_all2=Vo_Z-Vo_all2; %fprintf("不带%f 带%f\n",Vo_all,Vo_all2); F=Vo_all2/Vo_all; % fun1=@(x) 2/3*(H-A*x^2)^1.5; % Vo_z1=quadv(fun1,x_left,x_min); % Vo_z1=Vo_z1*2/B^0.5; % % fun2=@(x) (tan(z)*x+c-A*x^2-(tan(z)*x+c-A*x^2)/3)*sqrt(tan(z)*x+c-A*x^2); % Vo_z2=quadv(fun2,x_min,x_max); % Vo_z2=Vo_z2*2/B^0.5; % Vo_z_all=Vo_z1+Vo_z2; % % fun3=@(x)(H^2-A^2*x^4-(H-A*x^2)^2/5)*(H-A*x^2)^0.5; % Vo_a=quadv(fun3,x_left,x_min); % Vo_a=Vo_a*1/(B^0.5); % % fun4=@(x) ((tan(z)+c)^2-A*x^2*x^4-2/3*A*x^2*(tan(z)*x+c-A*x^2)-(tan(z)*x+c-A*x^2)^2/5)*(tan(z)*x+c-A*x^2)^0.5; % Vo_a2=quadv(fun4,x_min,x_max); % Vo_a2=Vo_a2*1/(B^0.5); % Vo_all=Vo_a+Vo_a2; % fprintf("Z这里的浮心：%f %f\n",Vo_a,Vo_a2); % % F=Vo_all/Vo_z_all; End 第三阶段浮心X: function F=float_X_90_180(A,B,H,V_boat,z) c=get_intercept_90_180(A,B,H,V_boat,z); d=(tan(z)^2+4*A*c)^0.5; x_min=(H-c)/tan(z); x_max=(tan(z)+d)/(2*A); x_l=-(H/A)^0.5; x_r=(H/A)^0.5; %全部的 fun1=@(x) (tan(z)-A*x^2)*(tan(z)+c-A*x^2)^0.5; Vo_1=quadv(fun1,x_min,x_max); Vo_1=Vo_1*4/(3*B^0.5); fun2=@(x) (H-A*x^2-(H-A*x^2)/3)*(H-A*x^2)^0.5; Vo_2=quadv(fun2,x_min,x_l); Vo_2=Vo_2*2/B^0.5; Vo_total=quadv(fun2,x_l,x_r); Vo_total=Vo_total*2/(1*B^0.5); Vo_all=Vo_total-(Vo_1+Vo_2); %带x的 检查 fun3=@(x) x*(H-tan(z)+c)*(tan(z)+c-A*x^2)^0.5; Vo_3=quadv(fun3,x_min,x_max); Vo_3=Vo_3*4/(3*B^0.5); fun4=@(x) 2/3*x*(H-A*x^2)^1.5; Vo_4=quadv(fun4,x_max,x_r); Vo_4=Vo_4*2/B^0.5; Vo_all2=Vo_3+Vo_4; %fprintf("不带%f 带%f\n ",Vo_all,Vo_all2); F=-Vo_all2/Vo_all; % %x轴积分体积区域 % fun1=@(x) x*2/3*(H-A*x^2)^1.5; % Vo_x=quadv(fun1,x_left,x_min); % Vo_x=Vo_x*2/B^0.5; % % fun2=@(x) x*(tan(z)*x+c-A*x^2-(tan(z)*x+c-A*x^2)/3)*sqrt(tan(z)*x+c-A*x^2); % Vo_X=quadv(fun2,x_min,x_max); % Vo_X=Vo_X*2/B^0.5; % Vo_xall=Vo_X+Vo_x; % fprintf("X这里的浮心：%f %f\n",Vo_x,Vo_X); % % %整体区域 % % fun1=@(x) 2/3*(H-A*x^2)^1.5; % Vo_x1=quadv(fun1,x_left,x_min); % Vo_x1=Vo_x1*2/B^0.5; % % fun2=@(x) (tan(z)*x+c-A*x^2-(tan(z)*x+c-A*x^2)/3)*sqrt(tan(z)*x+c-A*x^2); % Vo_x2=quadv(fun2,x_min,x_max); % Vo_x2=Vo_x2*2/B^0.5; % Vo_x_all=Vo_x1+Vo_x2; % % F=Vo_xall/Vo_x_all; end 第四阶段： function F=get_intercept_last(A,B,H,vp,z) cof=4/(3*sqrt(B)); i=1; cmin=0;%左上交点 cmax=H+tan(z)*sqrt(H/A);%左上角交点 c=double((cmin+cmax)/2); while(i<100) d=tan(z)^2+4*A*c; xL=(tan(z)-sqrt(d))/(2*A); xR=(tan(z)+sqrt(d))/(2*A); xmin=-sqrt(H/A); xmax=sqrt(H/A); fun1=@(x) (tan(z)*x+c-A*x.^2).^1.5; v1=quadv(fun1,xL,xR); v1=v1*cof;%水下 fun2=@(x) (H-A*x.^2).^1.5; v2=quadv(fun2,xmin,xL); v2=v2*cof;%水上左 v=quadv(fun2,xmin,xmax); v=v*cof;%水总 volumn=v-v1-v2; if(volumn<vp)%体积小，太高了 if(c<cmax) cmax=c; end end if(volumn>vp)%体积大，太低了 if(c>cmin) cmin=c; end end if(volumn==vp) break; end c=double((cmin+cmax)/2); i=i+1; end F=c; %fprintf("%f\n",c); End 第四阶段浮心X： function F=float_X_theat_180(A,B,H,theta,c) d=tan(theta)^2+4*A*c; xmin=-sqrt(H/A);%左极限点x xL=(H-c)/tan(theta);%左交点x xR=(tan(theta)+sqrt(d))/(2*A);%右交点x xmax=sqrt(H/A);%右极限点x cof=4/(3*sqrt(B)); fun1=@(x) (tan(theta)*x+c-A*x.^2).^1.5; v1=quadv(fun1,xL,xR);v1=v1*cof; fun2=@(x) (H-A*x.^2).^1.5; v2=quadv(fun2,xmin,xL);v2=v2*cof; v=quadv(fun2,xmin,xmax);v=v*cof; volumn=v-v1-v2; %小v为体积，大V是关于x的体积积分 Fun1=@(x) x.*(tan(theta)*x+c-A*x.^2).^1.5; V1=quadv(Fun1,xL,xR);V1=V1*cof; Fun2=@(x) x.*(H-A*x.^2).^1.5; V2=quadv(Fun2,xmin,xL);V2=V2*cof; %fprintf("volumn is %f, Vx1 is %f,",volumn,V1);%测试输出 F=-(V1+V2)/volumn; % c=get_intercept_theat_180(A,B,H,V_boat,z); % d=(tan(z)^2+4*A*c)^0.5; % % x_min=(tan(z)-d)/(2*A); % x_max=(tan(z)+d)/(2*A); % x_l=-(H/A)^0.5; % x_r=(H/A)^0.5; % %全部的 % fun1=@(x) (H-A*x^2)^1.5; % Vo_1=quadv(fun1,x_min,x_max); % Vo_1=Vo_1*4/(3*B^0.5); % fun2=@(x) (H-A*x^2)^1.5; % Vo_total=quadv(fun2,x_l,x_r); % Vo_total=Vo_total*4/(3*B^0.5); % Vo_all=Vo_total-Vo_1; % % %带x的 检查 % fun3=@(x) x*(H-A*x.^2)^1.5; % Vo_3=quadv(fun3,x_min,x_max); % Vo_3=Vo_3*4/(3*B^0.5); % fun4=@(x) x*(H-A*x.^2)^1.5; % Vo_4=quadv(fun4,x_l,x_r); % Vo_4=Vo_4*4/(3*B^0.5); % Vo_all2=Vo_4-Vo_3; % %fprintf("X不带%f 带%f\n ",Vo_1,Vo_total); % F=Vo_all2/Vo_all; % %x轴积分体积区域 % fun1=@(x) x*2/3*(H-A*x^2)^1.5; % Vo_x=quadv(fun1,x_left,x_min); % Vo_x=Vo_x*2/B^0.5; % % fun2=@(x) x*(tan(z)*x+c-A*x^2-(tan(z)*x+c-A*x^2)/3)*sqrt(tan(z)*x+c-A*x^2); % Vo_X=quadv(fun2,x_min,x_max); % Vo_X=Vo_X*2/B^0.5; % Vo_xall=Vo_X+Vo_x; % fprintf("X这里的浮心：%f %f\n",Vo_x,Vo_X); % % %整体区域 % % fun1=@(x) 2/3*(H-A*x^2)^1.5; % Vo_x1=quadv(fun1,x_left,x_min); % Vo_x1=Vo_x1*2/B^0.5; % % fun2=@(x) (tan(z)*x+c-A*x^2-(tan(z)*x+c-A*x^2)/3)*sqrt(tan(z)*x+c-A*x^2); % Vo_x2=quadv(fun2,x_min,x_max); % Vo_x2=Vo_x2*2/B^0.5; % Vo_x_all=Vo_x1+Vo_x2; % % F=Vo_xall/Vo_x_all; End 第四阶段浮心Z: function F=float_Z_theat_180(A,B,H,theta,c) d=tan(theta)^2+4*A*c; xmin=-sqrt(H/A);%左极限点x xL=(H-c)/tan(theta);%左交点x xR=(tan(theta)+sqrt(d))/(2*A);%右交点x xmax=sqrt(H/A);%右极限点x cof=4/(3*sqrt(B));Cof=1/sqrt(B); fun1=@(x) (tan(theta)*x+c-A*x.^2).^1.5;%右边 v1=quadv(fun1,xL,xR);v1=v1*cof; fun2=@(x) (H-A*x.^2).^1.5;%左边 v2=quadv(fun2,xmin,xL);v2=v2*cof; v=quadv(fun2,xmin,xmax);v=v*cof; volumn=v-v1-v2; %小v为体积，大V是关于z的体积积分 Fun1=@(x) ((tan(theta)*x+c).^2-A^2*x.^4).*sqrt(tan(theta)*x+c-A*x.^2)-2*A*x.^2.*(H-A*x.^2).^1.5/3-(tan(theta)*x+c-A*x.^2).^2.5/5; V1=quadv(Fun1,xL,xR);V1=V1*Cof; Fun2=@(x) (H^2-A^2*x.^4).*sqrt(H-A*x.^2)-2*A*x.^2.*(H-A*x.^2).^1.5/3-(H-A*x.^2).^2.5/5; V2=quadv(Fun2,xmin,xL);V2=V2*Cof; V=quadv(Fun2,xmin,xmax);V=V*Cof; Vz=V-V1-V2; F=Vz/volumn; % c=get_intercept_theat_180(A,B,H,V_boat,z); % d=(tan(z)^2+4*A*c)^0.5; % x_min=(tan(z)-d)/(2*A); % x_max=(tan(z)+d)/(2*A); % x_r=(H/A)^0.5; % x_l=-(H/A)^0.5; % % % fprintf("%f %f\n",z*180/pi,c); % fun1=@(x) ((tan(z)*x+c)-A*x^2)^1.5; % Vo_1=quadv(fun1,x_min,x_max); % Vo_1=Vo_1*4/(3*B^0.5); % fun2=@(x) (H-A*x.^2)^1.5; % Vo_2=quadv(fun2,x_l,x_r); % Vo_2=Vo_2*4/(3*B^0.5); % Vo_all=Vo_2-Vo_1; % % % fun3=@(x) (H^2-A^2*x^4-2*A*(H-A*x^2)/3-(H-A*x^2)^2/5)*(H-A*x^2)^0.5; % Vo_3=quadv(fun3,x_min,x_max); % Vo_3=Vo_3/B^0.5; % fun4=@(x) (H^2-A^2*x^4)*sqrt(H-A*x^2)-2*A*x^2*(H-A*x^2)^1.5/3-(H-A*x^2)^2.5/5; % Vo_4=quadv(fun4,x_l,x_r); % Vo_4=Vo_4*1/B^0.5; % Vo_all2=Vo_3-Vo_4; % % fprintf("Z不带%f 带%f\n",Vo_1,Vo_2); % F=Vo_all2/Vo_all; end 寻找西塔角度： function F_=the_0_to_xita(A,B,H,V_boat) pre=8/(3*B^0.5); fun_of_tail=@(x) (H-A*x^.2).^1.5; v=quadv(fun_of_tail,0,sqrt(H/A)); v=v*pre; H_min=0; H_max=H; H_temp=double(H_min+H_max)/2; i=1; while(i<1000) F_change=@(x) (H_temp-A*x^2)^1.5; x_max=(H_temp/A)^0.5; V_temp=quadv(F_change,0,x_max); V_temp=V_temp*pre; if(V_temp>V_boat) if(H_temp<H_max) H_max=H_temp; end end if(V_temp<V_boat) if(H_temp>H_min) H_min=H_temp; end end if(V_temp==V_boat) break; end H_temp=double(H_min+H_max)/2; i=i+1; end F_=H_temp; End 画图函数： 铁的质量增加： function F=get_add_tie_art(A,B,H) V_boat=0.0004; T=[]; U=[]; i=1; while(V_boat<0.0014) T=[T V_boat]; f_water_line=the_0_to_xita(A,B,H,V_boat);%吃水线 U=[U f_water_line]; plot(T,U); xlabel('x,重量'); ylabel('y,吃水线'); title('重量改变曲线图'); V_boat=V_boat+0.00001; i=i+1; end F=1; End 三维曲面图： %三维图 colormap(hsv) ; t=-0.5:0.04:0.5; A=10; B=6; H=0.15; [x,y] =meshgrid(t); z=A*x.^4+B*y.^2; surf(x,y,z); hold on; colormap(cool) ; [X,Y] =meshgrid(t); Z=-Y*tand(20)+0.05;%得到的角度和c surf(X,Y,Z); xlabel('X'); ylabel('Y'); zlabel('Z'); title('surf三维曲面图'); axis([-0.5 0.5 -0.5 0.5 0 H]); 二维曲面图： %2D图 clear; x=-0.2:0.01:0.2; A=10; H=0.12; y=A*x.^2; plot(x,y); hold on; plot([-0.2 0.2],[0.4 0.4]) y=x*tand(66)+ 0.1; plot(x,y) axis equal; axis([-0.5 0.5 0 0.5]); 吃水线方程： function F=water_line_art(A,B,H,water_line) water_line=water_line*1000; fsurf(@(x,y) A*x.^2+B*y.^2); zlim([0 H*1000]); hold on; fsurf(water_line); F=1; end
