strility/-/蟹小船/装配体1.SLDASM

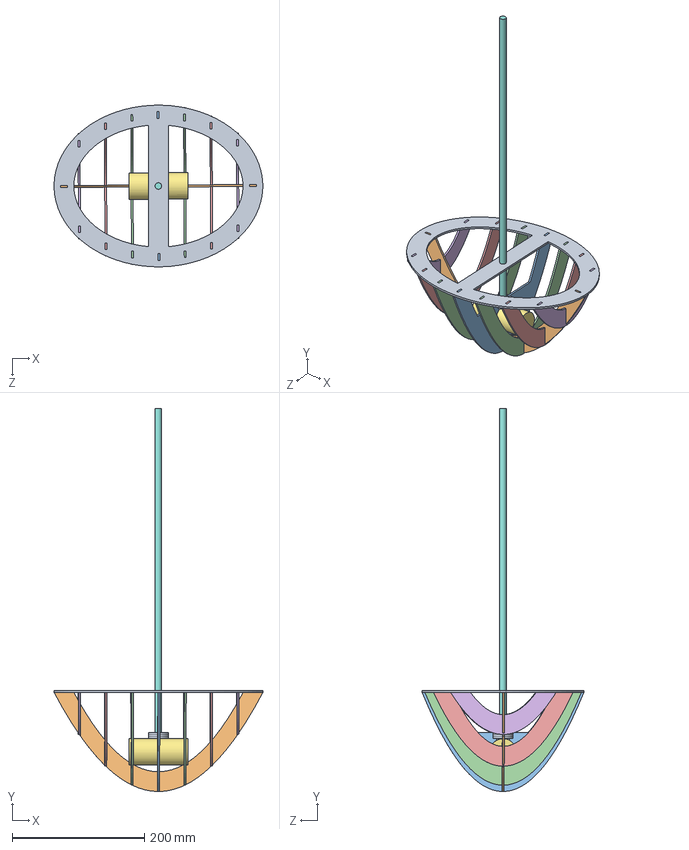
[picture p19: CAD file, 2019-11-16]
蟹小船/装配体1.SLDASM
316.2 x 580.0 x 245.0 mm
甲板
龙骨
中间肋板
肋板1 x 2
肋板2 x 2
肋板3 x 2
铁块
零件6
垫片 x 3
