strility/-/蟹小船/零件6.SLDPRT

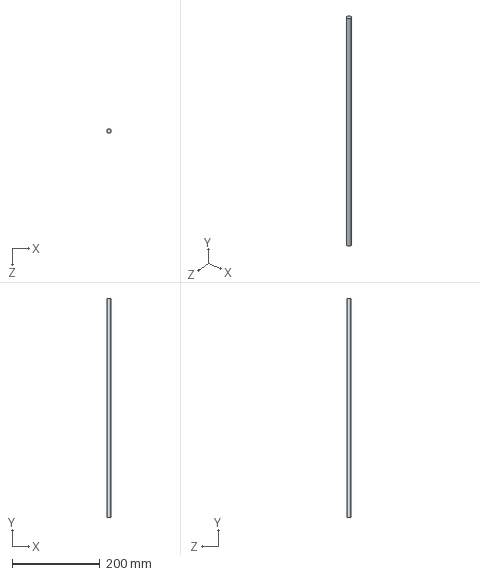
[picture p20: CAD file, 2019-11-16]
蟹小船/零件6.SLDPRT
10.0 x 500.0 x 10.0 mm
