strility/-/蟹小船/肋板1.SLDPRT

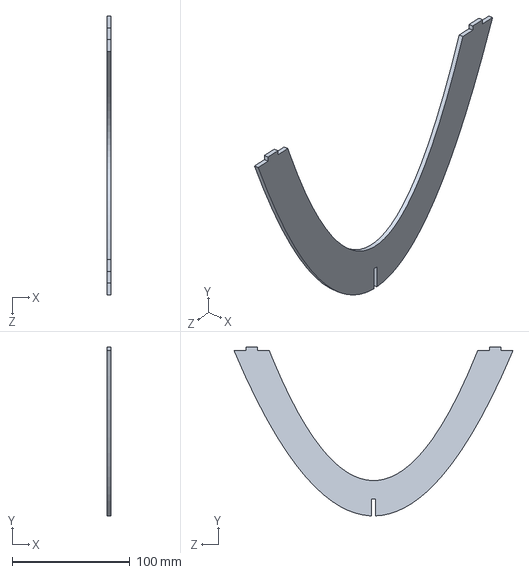
[picture p21: CAD file, 2019-11-16]
蟹小船/肋板1.SLDPRT
3.00 x 143.4 x 237.0 mm
