strility/-/蟹小船/铁块.SLDPRT

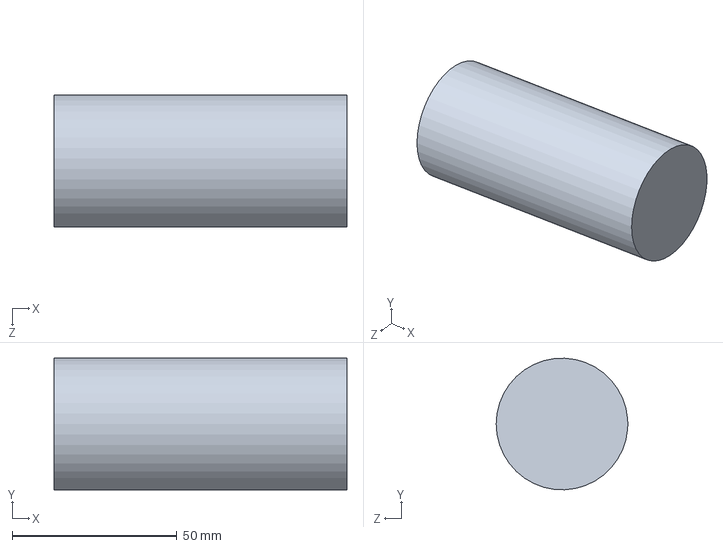
[picture p22: CAD file, 2019-11-16]
蟹小船/铁块.SLDPRT
89.0 x 40.0 x 40.0 mm
