strility/-/蟹小船/垫片.SLDPRT

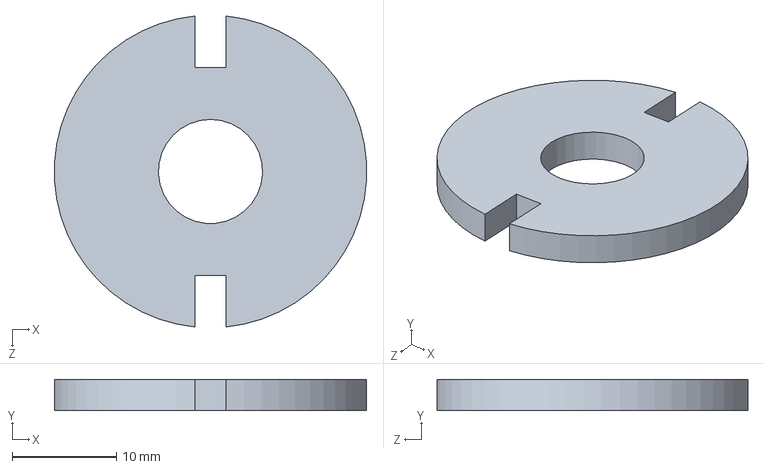
[picture p23: CAD file, 2019-11-16]
蟹小船/垫片.SLDPRT
29.9 x 3.00 x 29.8 mm
