strility/-/蟹小船/肋板3.SLDPRT

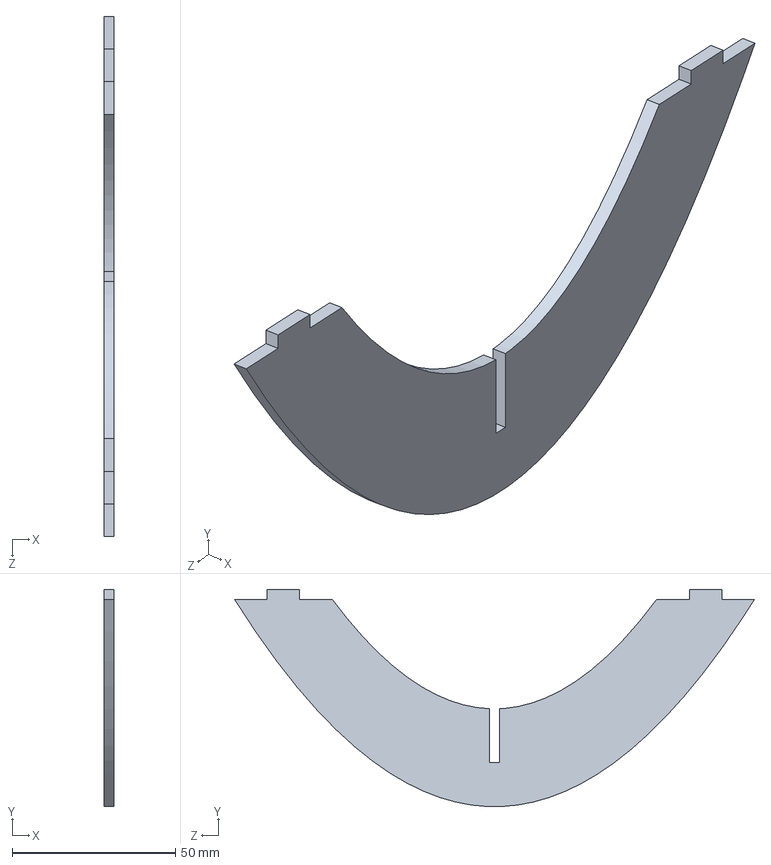
[picture p24: CAD file, 2019-11-16]
蟹小船/肋板3.SLDPRT
3.00 x 66.5 x 159.5 mm
