strility/-/蟹小船/中间肋板.SLDPRT

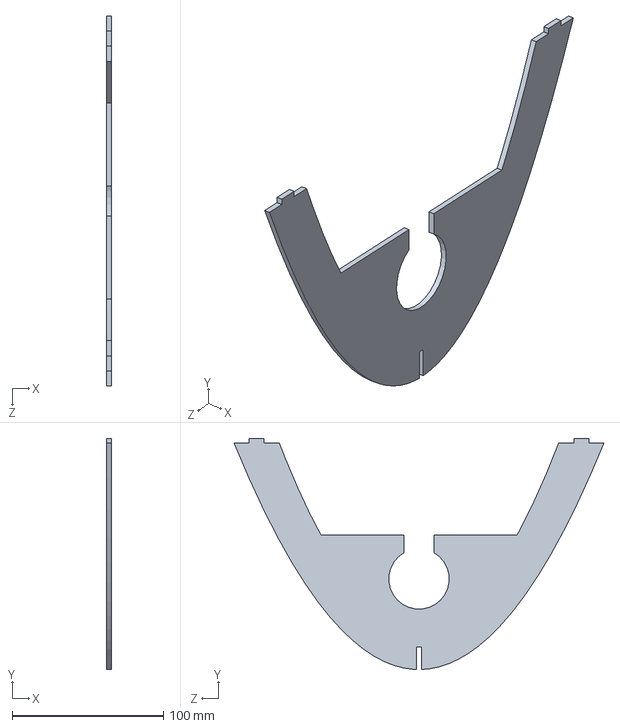
[picture p25: CAD file, 2019-11-16]
蟹小船/中间肋板.SLDPRT
3.00 x 153.0 x 244.9 mm
