strility/-/蟹小船/龙骨.SLDPRT

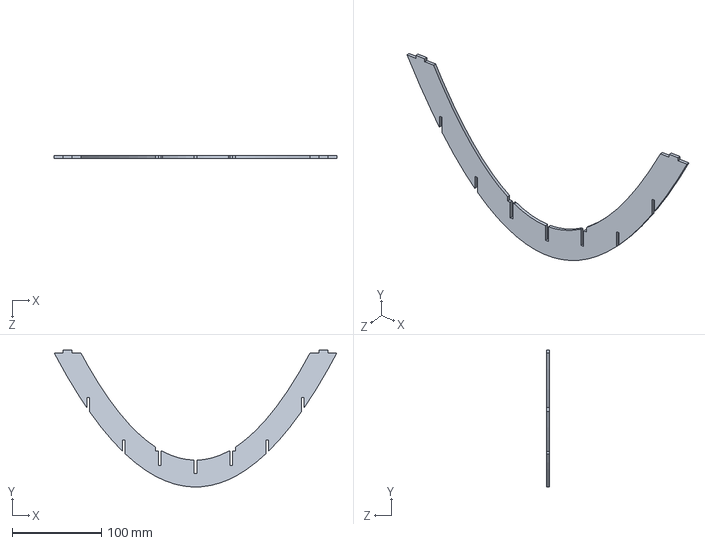
[picture p26: CAD file, 2019-11-16]
蟹小船/龙骨.SLDPRT
316.2 x 152.9 x 3.00 mm
