strility/-/蟹小船/裁剪图.dxf

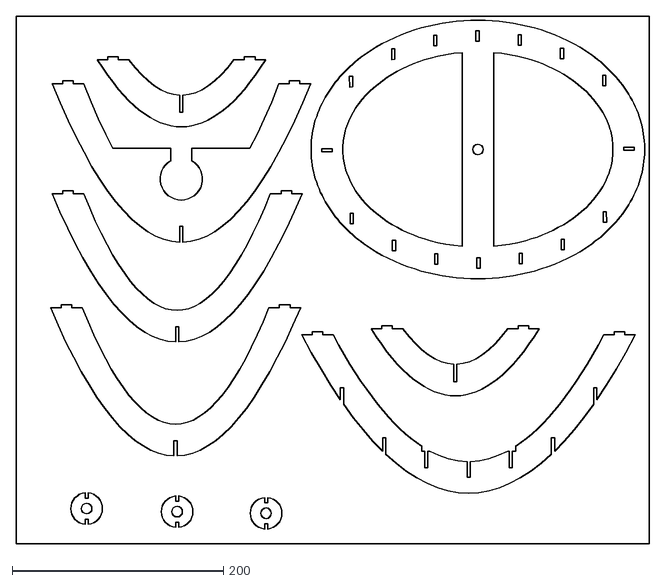
[picture p27: CAD file, 2019-11-16]
蟹小船/裁剪图.dxf
600.0 x 500.0
