strility/-/蟹小船/16-40-徐炜涛-罗文荣.dxf

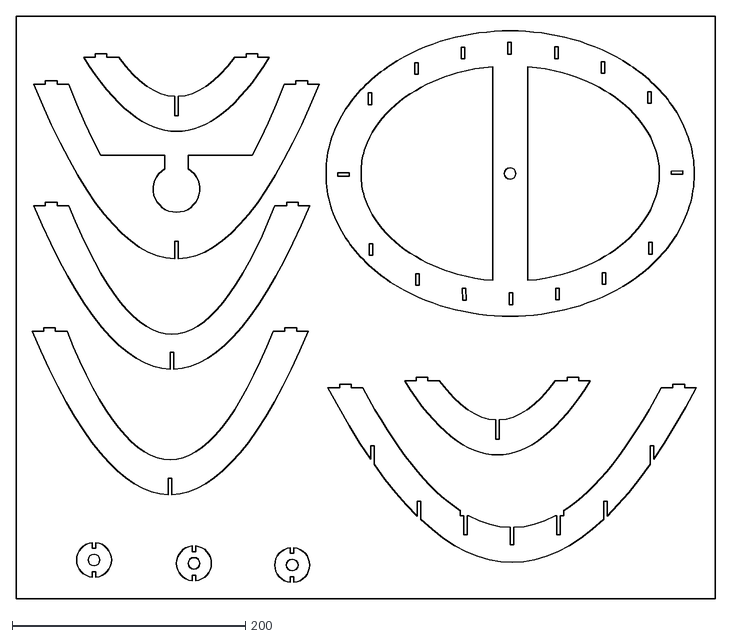
[picture p28: CAD file, 2019-11-16]
蟹小船/16-40-徐炜涛-罗文荣.dxf
600.0 x 500.0
