strility/-/蟹小船/甲板.SLDPRT

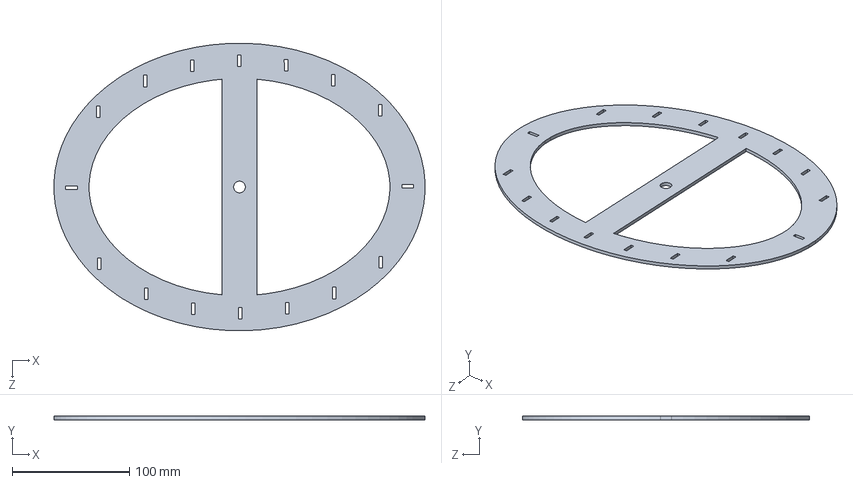
[picture p29: CAD file, 2019-11-16]
蟹小船/甲板.SLDPRT
316.0 x 3.00 x 244.8 mm
