strility/-/蟹小船/肋板2.SLDPRT

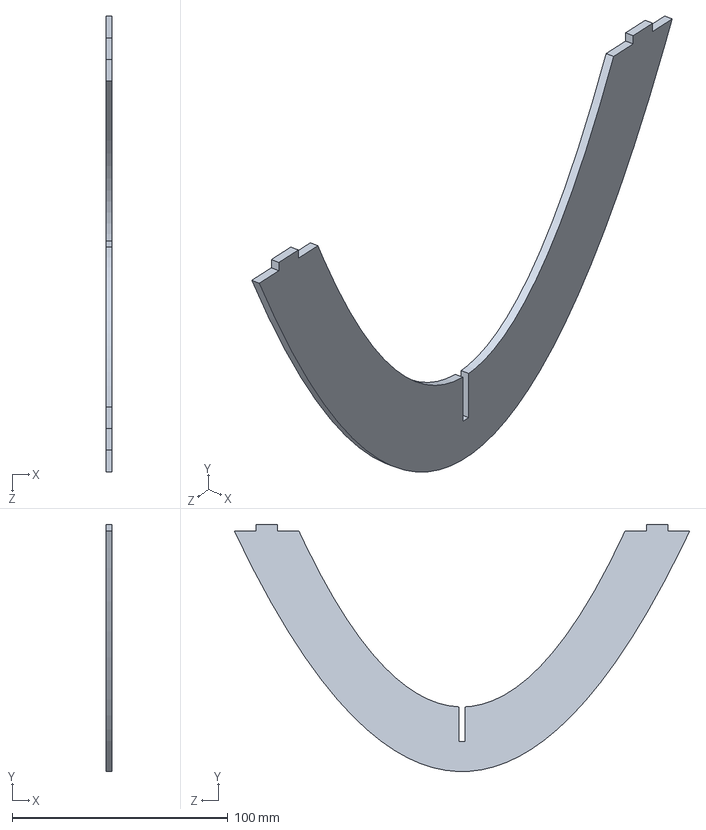
[picture p30: CAD file, 2019-11-16]
蟹小船/肋板2.SLDPRT
3.00 x 114.6 x 211.3 mm
