strility/-/(list of files, cad)

Other CAD files:
蟹小船/中间肋板.DWG
蟹小船/垫片.DWG
蟹小船/甲板.DWG
蟹小船/肋板1.DWG
蟹小船/肋板2.DWG
蟹小船/肋板3.DWG
蟹小船/裁剪图.dwg
蟹小船/龙骨.DWG
